import-tiago/It-s-Time-Do/README.md

# It's Time, Do!

__It's Time, Do!__ is a system (hardware + firmware + web application) to control over the internet the on/off or programming to automatically run other devices and electronic equipments.

The inspiration for creating this project comes from the need to schedule my ~~not smart~~ washing machine to auto-start when I'm out and about to save time and just put the clothes to dry when I get home.

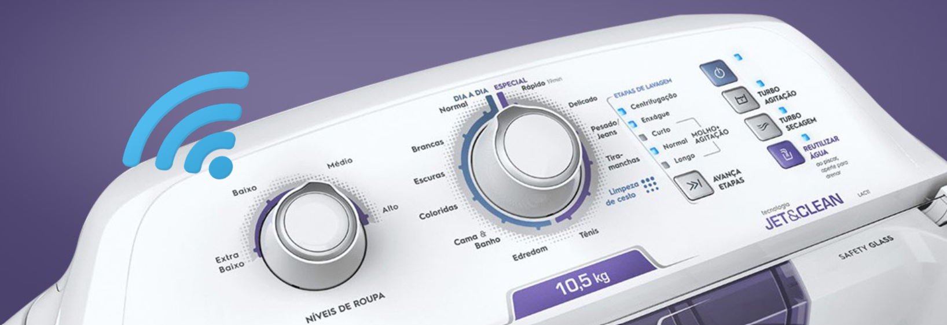
[picture p1: Assets/WashMachinePanel.png]
WashingMachine


## Push Notifications
The hardware device can trigger a web push notification to notify web clients of tasks that have started or ended (either previously scheduled tasks or even tasks that have been started locally).

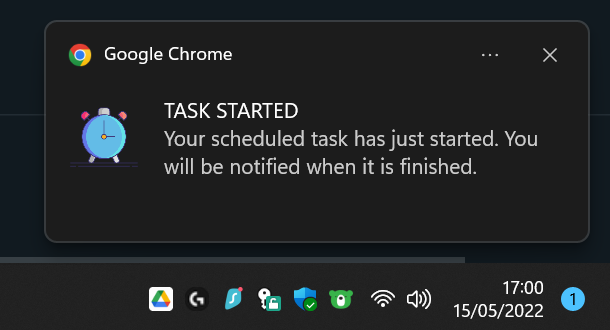
[picture p2: Assets/WebPushNotificationStartTask.png]
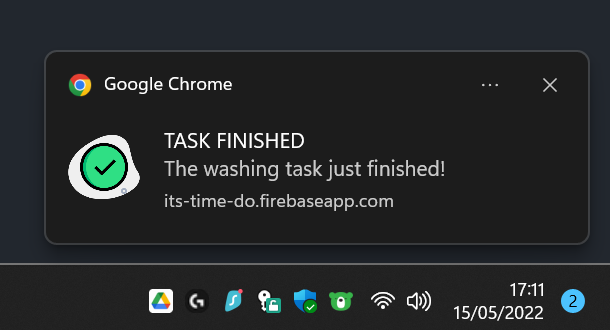
[picture p3: Assets/WebPushNotificationFinishedTask.png]
|  |  |
|--|--|
  
 ## Task History and Instant Data
 Through Firebase's Real Time Database (RTDB), it is possible to monitor instant __It's Time, Do!__ hardware device parameters, such as local date, local time, status of the scheduled task and current firmware version; as well as status of the device being controlled (in my case, the washing machine), whether or not it is working, log of all previous tasks with start and finished date and time of each one.
 <p align="center"><img src="https://github.com/import-tiago/It-s-Time-Do/blob/main/Assets/RTDB_Preview.png" width=70%" height="70%"></p>
  
## Hardware / Circuit Diagram
Controller: [M5StickC PLUS](https://docs.m5stack.com/en/core/m5stickc_plus) - [M5Stack Official Store](https://pt.aliexpress.com/item/1005003297502591.html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)<br/>
Module: [Unit Relay](https://docs.m5stack.com/en/unit/relay) - [M5Stack Official Store](https://pt.aliexpress.com/item/1005003299262655.html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)

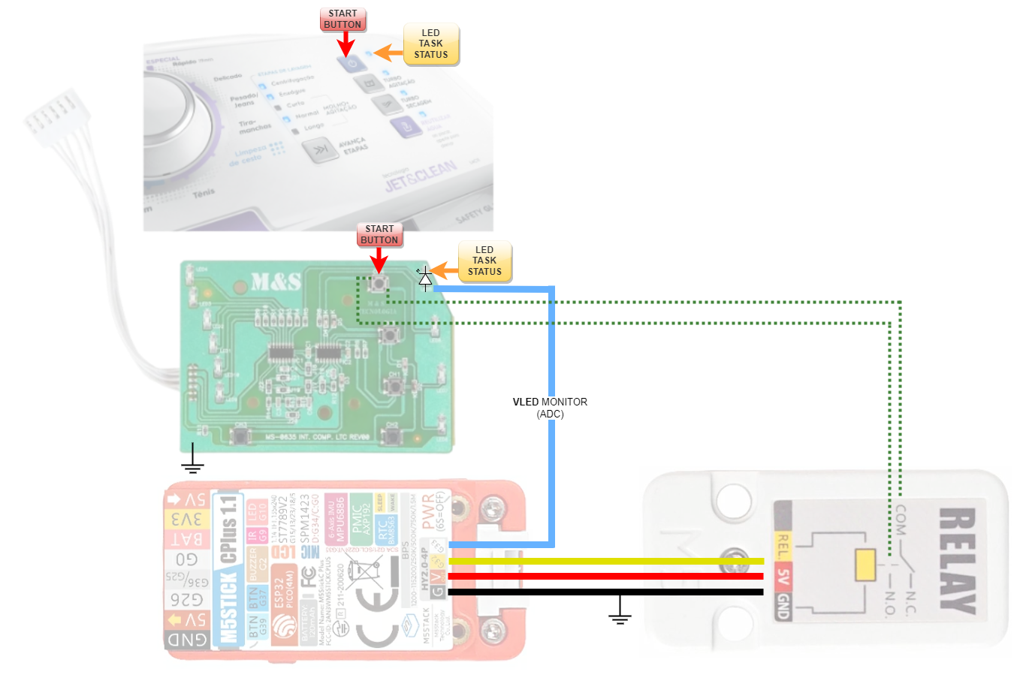
[picture p4: Assets/Circuit.png]
CircuitDiagram


### Contributing
0. Give this project a :star:
1. Create an issue and describe your idea.
2. [Fork it](https://github.com/import-tiago/It-s-Time-Do/fork).
3. Create your feature branch (`git checkout -b my-new-feature`).
4. Commit your changes (`git commit -a -m "Added feature title"`).
5. Publish the branch (`git push origin my-new-feature`).
6. Create a new pull request.
7. Done! :heavy_check_mark:

### License Information
<br /><span xmlns:dct="http://purl.org/dc/terms/" property="dct:title">It's Time, Do!</span> by <a xmlns:cc="http://creativecommons.org/ns#" href="https://twitter.com/import_tiago" property="cc:attributionName" rel="cc:attributionURL">Tiago Silva</a> is licensed under a <a rel="license" href="http://creativecommons.org/licenses/by-nc-sa/4.0/">Creative Commons Attribution-NonCommercial-ShareAlike 4.0 International License</a>.
