import-tiago/It-s-Time-Do/Assets/HardwareUsed.png

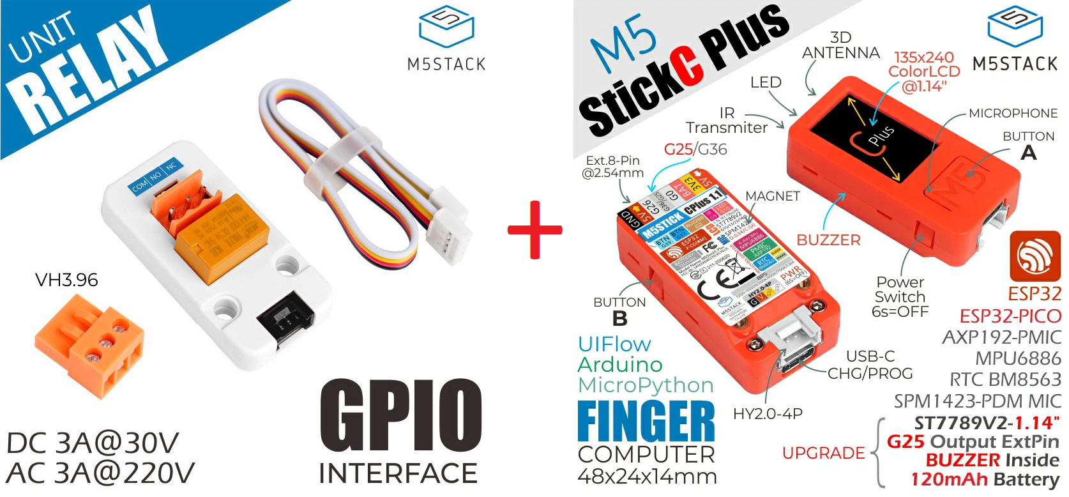
Assets/HardwareUsed.png
