import-tiago/It-s-Time-Do/Assets/RTDB_Preview.png

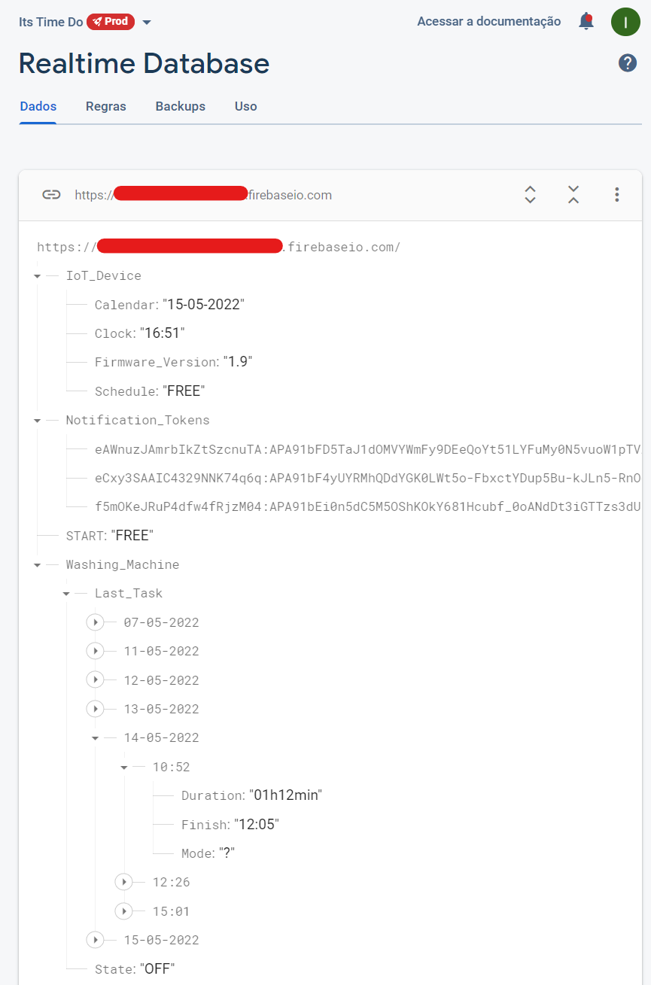
Assets/RTDB_Preview.png
