import-tiago/It-s-Time-Do/Assets/WashMachinePanel_and_PCB.png

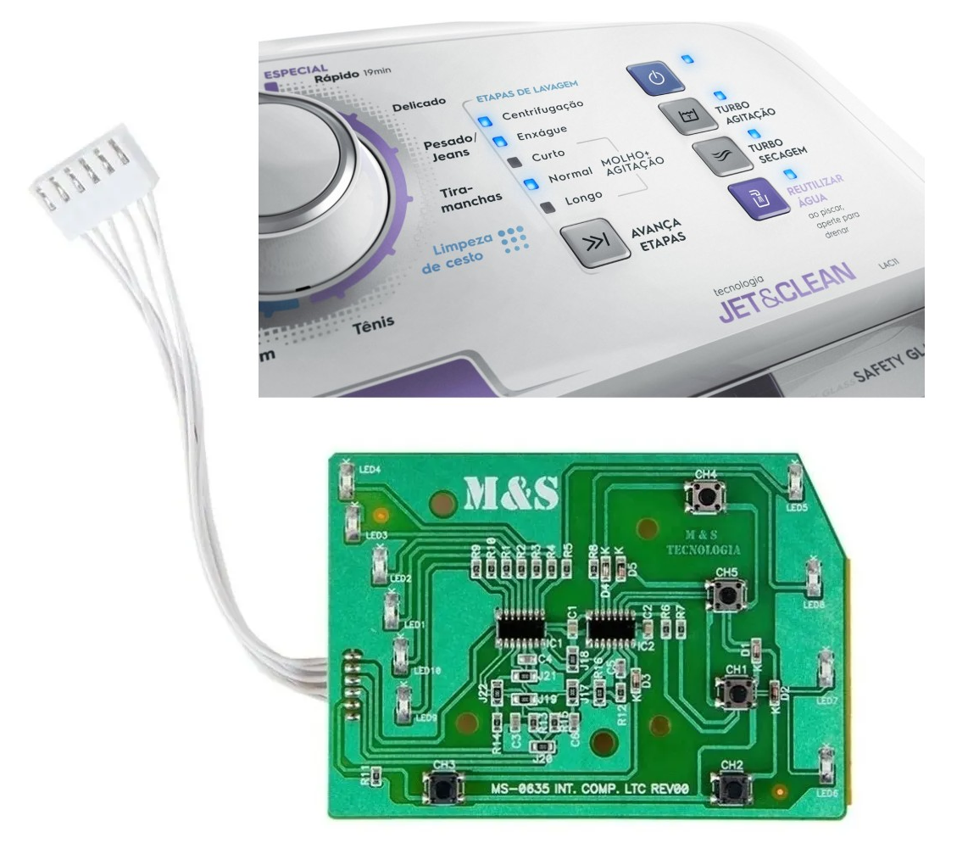
Assets/WashMachinePanel_and_PCB.png
