import-tiago/It-s-Time-Do/Hardware/M5StickC PLUS/Pinout_BOTTOM.webp

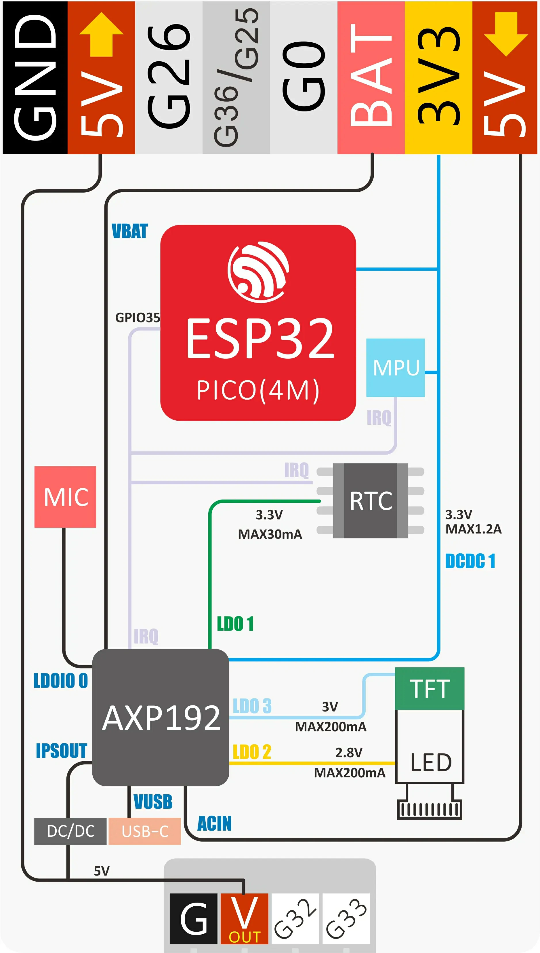
Hardware/M5StickC PLUS/Pinout_BOTTOM.webp
