import-tiago/It-s-Time-Do/Hardware/M5StickC PLUS/Pinout_TOP.webp

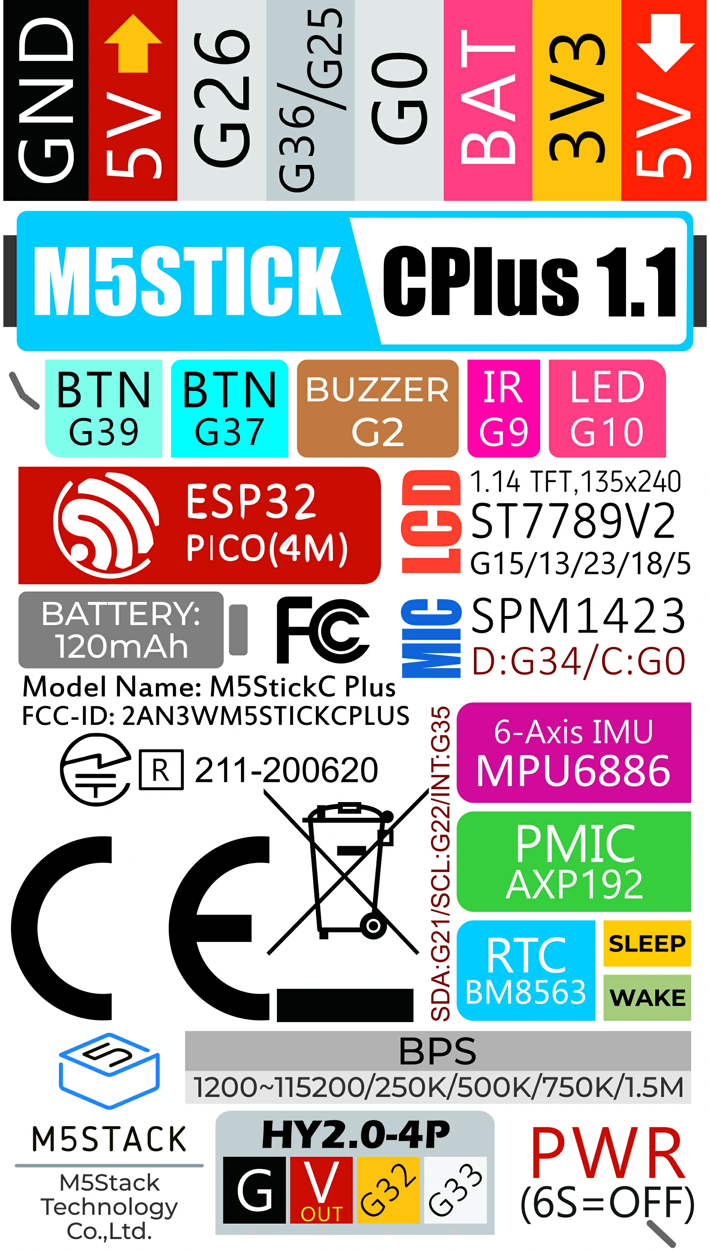
Hardware/M5StickC PLUS/Pinout_TOP.webp
