import-tiago/It-s-Time-Do/Hardware/0. Project/It-s Time, Do.brd

## EAGLE design Hardware/0. Project/It-s Time, Do.brd (2022-06-18, last stored version)

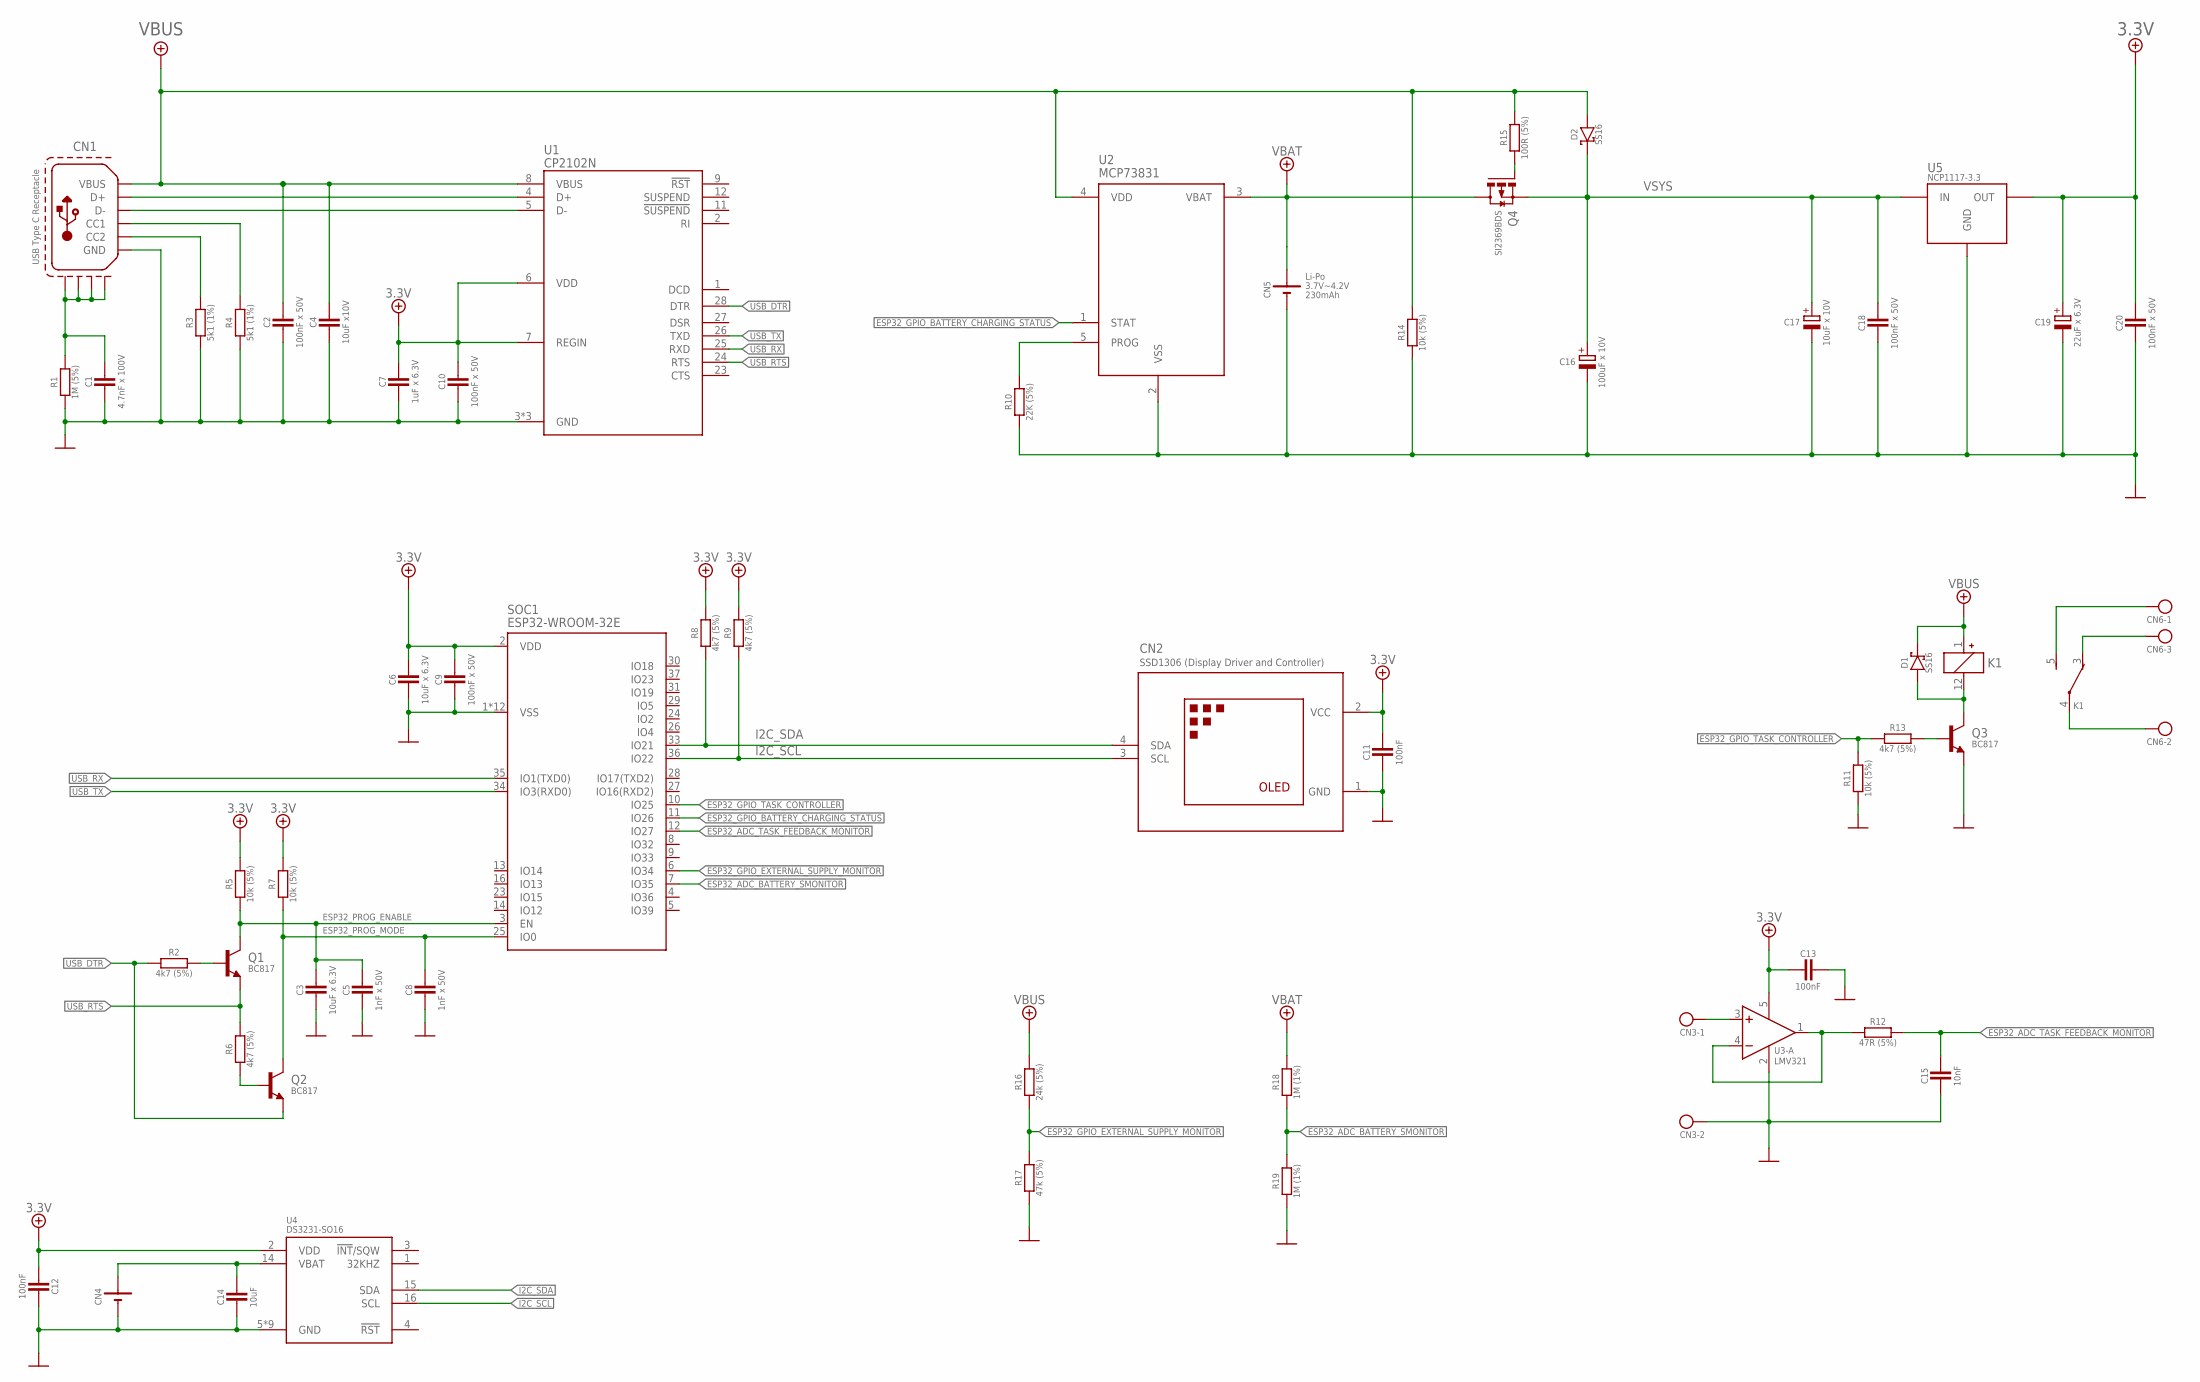
[picture p10: schematic It-s Time, Do.sch, Complete Schematic]

Parts:
C1: 4.7nF x 100V; C0603
C2, C9, C10, C18, C20: 100nF x 50V; C0603
C3, C6: 10uF x 6.3V; C0603
C4: 10uF x10V; C0603
C5, C8: 1nF x 50V; C0603
C7: 1uF x 6.3V; C0603
C11, C12, C13: 100nF; C0603; PARTNO *
C14: 10uF; C0603; PARTNO GRJ155R60J106ME11D
C15: 10nF; C0603
C16: 100uF x 10V; PTH-5MM
C17: 10uF x 10V; C1206_POL
C19: 22uF x 6.3V; C1206_POL
CN1: USB Type C Receptacle; USB-C-16P-2LAYER-PADS
CN2: OLED-MODULE-I2C-SOCKET; PIN_HEADER_1X4_FEMALE
CN3: 2P-MINI-FIT-JR; MINI-FIT-JR-2P
CN4: CR1220; CR1220/1225_HOLDER2; PARTNO *
CN5: BATTERY; JST-PH-2P-H; VOLTAGE 3.7V~4.2V
CN6: 3P-MINI-FIT-JR; MINI-FIT-JR-3P
D1: FM4004; DO-214AC
D2: SCHOTTKY-SS16; DO-214AC
K1: DPDT-SMD; EE2-5NU
Q1, Q2: NPN-BC817; SOT23-3
Q3: BC817; SOT23-3
Q4: P-FET-ENHANCEMENT-SI2369BDS; SOT23-3
R1: 1M (5%); R0603
R2, R6, R8, R9, R13: 4k7 (5%); R0603
R3, R4: 5k1 (1%); R0603
R5, R7, R11, R14: 10k (5%); R0603
R10: 22K (5%); R0603; PARTNO *
R12: 47R (5%); R0603
R15: 100R (5%); R0603
R16: 24k (5%); R0603; PARTNO RC0402FR-0724KL
R17: 47k (5%); R0603; PARTNO RC0402FR-0747KL
R18, R19: 1M (1%); R0603; PARTNO *
SOC1: ESP32-WROOM-32E
U1: CP2102N; QFN-28
U2: MCP73831; SOT-23-5; PARTNO *
U3: LMV321; SOT-23-5
U4: DS3231-SO16; SOIC-16W_(SO16)
U5: 1117-3.3V; SOT-223-3

Connections:
0V: C1.1, C2.1, C3.2, C4.1, C5.2, C6.2, C7.1, C8.2, C9.2, C10.1, C11.2, C12.1, C13.1, C14.2, C15.2, C16.2 (-), C17.2 (-), C18.2, C19.2 (-), C20.2, CN1.GND, CN1.GND2 (GND), CN2.1 (GND), CN3.2, CN4.2 (-), CN5.2 (-), Q3.2 (E), R1.2, R3.2, R4.2, R10.1, R11.2, R14.1, R17.2, R19.1, SOC1.1 (VSS), SOC1.15 (VSS), SOC1.38 (VSS), SOC1.E1 (VSS), SOC1.E2 (VSS), SOC1.E3 (VSS), SOC1.E4 (VSS), SOC1.E5 (VSS), SOC1.E6 (VSS), SOC1.E7 (VSS), SOC1.E8 (VSS), SOC1.E9 (VSS), U1.3 (GND), U1.EXP (GND), U1.M (GND), U2.2 (VSS), U3.2 (V-), U4.5 (GND), U4.6 (GND), U4.7 (GND), U4.8 (GND), U4.9 (GND), U4.10 (GND), U4.11 (GND), U4.12 (GND), U4.13 (GND), U5.1 (GND)
3.3V: C6.1, C7.2, C9.1, C10.2, C11.1, C12.2, C13.2, C19.1 (+), C20.1, CN2.2 (VCC), R5.1, R7.1, R8.2, R9.2, SOC1.2 (VDD), U1.6 (VDD), U1.7 (REGIN), U3.5 (V+), U4.2 (VDD), U5.2 (OUT), U5.4 (OUT)
ESP32_ADC_BATTERY_SMONITOR: R18.1, R19.2, SOC1.7 (IO35)
ESP32_ADC_TASK_FEEDBACK_MONITOR: C15.1, R12.2, SOC1.12 (IO27)
ESP32_GPIO_BATTERY_CHARGING_STATUS: SOC1.11 (IO26), U2.1 (STAT)
ESP32_GPIO_EXTERNAL_SUPPLY_MONITOR: R16.2, R17.1, SOC1.6 (IO34)
ESP32_GPIO_TASK_CONTROLLER: R11.1, R13.2, SOC1.10 (IO25)
ESP32_PROG_ENABLE: C3.1, C5.1, Q1.3 (C), R5.2, SOC1.3 (EN)
ESP32_PROG_MODE: C8.1, Q2.3 (C), R7.2, SOC1.25 (IO0)
I2C_SCL: CN2.3 (SCL), R9.1, SOC1.36 (IO22), U4.16 (SCL)
I2C_SDA: CN2.4 (SDA), R8.1, SOC1.33 (IO21), U4.15 (SDA)
unnamed: CN1.B5 (CC2), R3.1
unnamed: CN1.A5 (CC1), R4.1
unnamed: CN1.A7 (D-), CN1.B7 (D-), U1.5 (D-)
unnamed: CN3.1, U3.3 (+IN)
unnamed: CN6.1, K1.5 (NO)
unnamed: CN1.A6 (D+), CN1.B6 (D+), U1.4 (D+)
unnamed: Q1.1 (B), R2.1
unnamed: Q2.1 (B), R6.1
unnamed: Q4.1 (G), R15.2
unnamed: R12.1, U3.1 (OUT), U3.4 (-IN)
unnamed: CN6.2, K1.4 (COM)
unnamed: CN6.3, K1.3 (NC)
unnamed: R10.2, U2.5 (PROG)
unnamed: Q3.1 (B), R13.1
unnamed: D1.2 (A), K1.12 (-), Q3.3 (C)
unnamed: C1.2, CN1.SHLD1 (S1), CN1.SHLD2 (S2), CN1.SHLD3 (S3), CN1.SHLD4 (S4), R1.1
P$1: CN5.1 (+), Q4.3 (D), R18.2, U2.3 (VBAT)
RTC_VBAT: C14.1, CN4.1 (+), U4.14 (VBAT)
USB_DTR: Q2.2 (E), R2.2, U1.28 (DTR)
USB_RTS: Q1.2 (E), R6.2, U1.24 (RTS)
USB_RX: SOC1.35 (IO1(TXD0)), U1.25 (RXD)
USB_TX: SOC1.34 (IO3(RXD0)), U1.26 (TXD)
VBUS: C2.2, C4.2, CN1.VBUS1 (VBUS), CN1.VBUS2 (VBUS), D1.1 (K), D2.2 (A), K1.1 (+), R14.2, R15.1, R16.1, U1.8 (VBUS), U2.4 (VDD)
VSYS: C16.1 (+), C17.1 (+), C18.1, D2.1 (K), Q4.2 (S), U5.3 (IN)

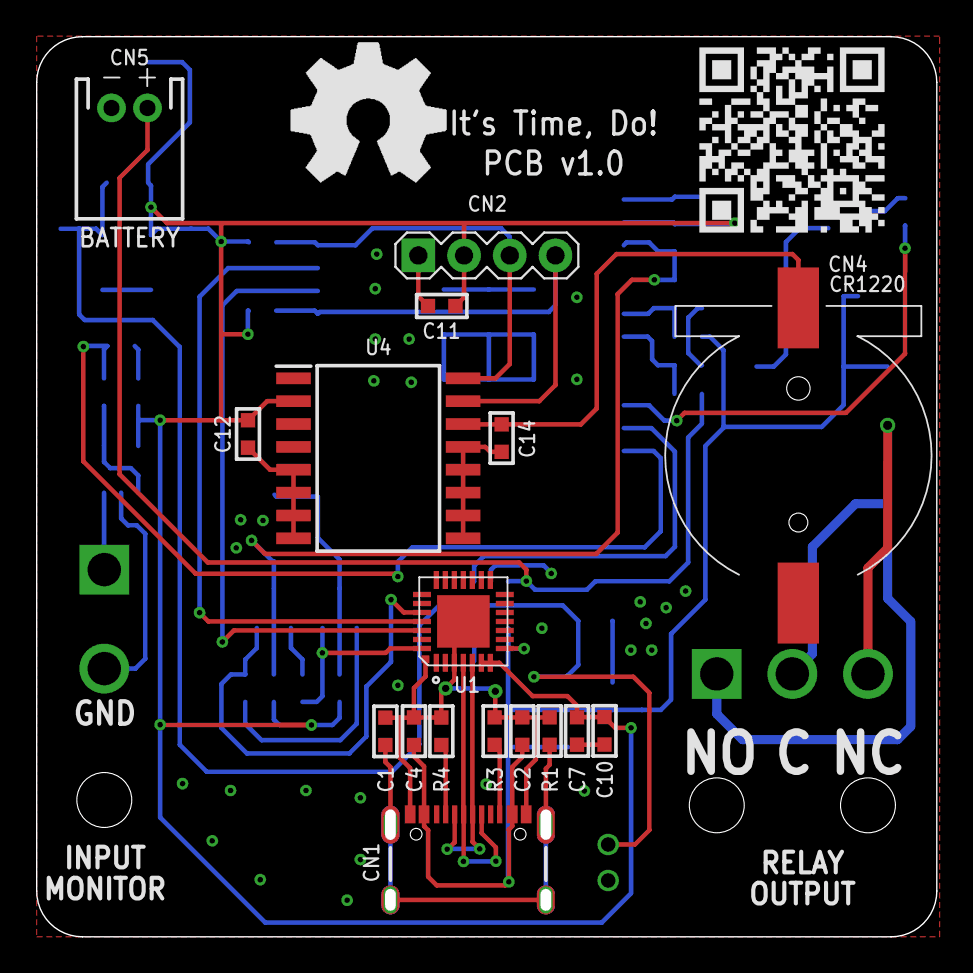
[picture p11: board It-s Time, Do.brd from above]

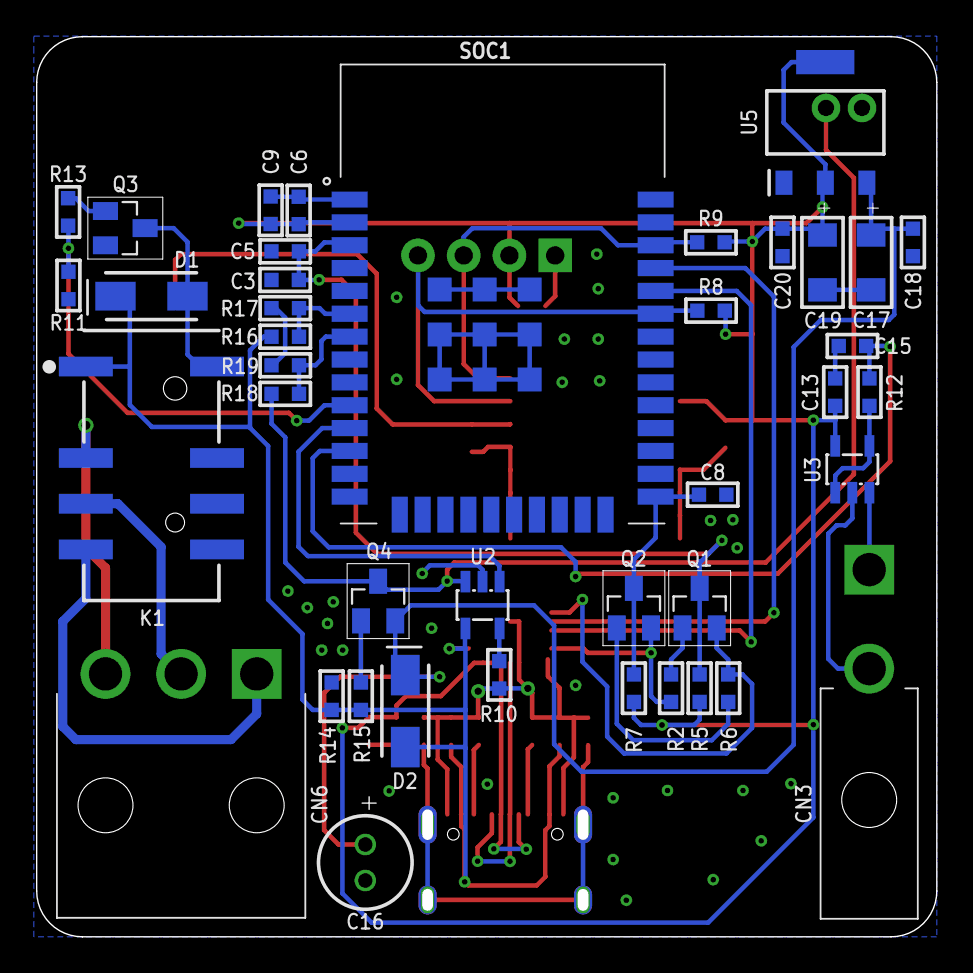
[picture p12: board It-s Time, Do.brd from below]

Board: 2 copper layers, 50.0 x 50.0 mm, 58 parts (41 on the bottom side), 35 nets.
