import-tiago/It-s-Time-Do/Firmware/src/main.cpp

#define FIRMWARE_VERSION "2.1"
/*
v1.0    - Initial release.
v1.1    - Bug fix in task duration calcs.
v1.2    - Update library 'Firebase-ESP32' from  v3.1.5 to v3.2.0.
v1.3    - Reading and writing data from/to server changed to JSON method.
		- More information besides 'task duration' added to the finished task log.
		- New data struct standard defined to store data in the real remote_time_adj database.
		- Print current task duration while waits the task finish.
		- Allows task duration monitor/log works from local or remote START trigger.
v1.4    - Enable Checks_OTA_Firmware_Update() on firmware start-up.
		- Enable Wi-Fi and Firebase connections status print on firmware start-up.
		- Checks if Firebase is ready before send JSON data to RTDB.
v1.4.1  - Bug fix: show working state at /START topic after remote trigger.
		- Bug fix: show free state at /START and /IoT_Device topics after task finished.
		- Send push notification when remote triggers occurs.
		- Calendar postion changed to fit firmware version text.
v1.4.2  - Bug fix: local trigger does not need trigger relay. Fixed.
v1.5    - Current firmware version sendind to RTDB.
v1.6    - New firmware structure based on finite state machine, no more just ISR.
v1.7  	- 'Firebase-ESP32' library updated from v3.2.0 to v3.3.0.
		- Minor improvements in variables/functions names (more intuitive code reading).
		- Bug fix in Last_Task fild (data being erased after some remote_time_adj).
v1.8 	- Static variables changed to extern where appropriate.
v1.8.1 	- Now, Firebase_Get runs 'FirebaseReady' to ensure the connection in while loops.
		- 'Firebase-ESP32' library updated from v3.3.0 to v3.2.2 (author's downgrade)
v1.9 	- 'Firebase-ESP32' library updated from v3.2.2 to v3.3.2.
		- Ensures that when task is RUNNING the /IoT_Device/Schedule shows status as RUNNING too.
v1.10 	- 'Firebase-ESP32' library updated from v3.3.2 to v3.3.6.
		- 'RTClib' library updated from v2.0.2 to v2.0.3.
v1.11 	- 'Firebase-ESP32' library updated from v3.3.6 to v4.0.0.
		- 'download_buffer_size' increased.
v1.12 	- Fixed espressif32 platform at v3.5.0 because mbedtls (associated function) seems to have broken a bunch of libraries using it at new versions.
v1.13 	- 'Firebase-ESP32' library updated from v4.0.0 to v4.1.0.
v2.0    - Porting whole firmware to a new hardware platform: M5StickC Plus.
v2.1    - RTC IC from M5StickC Plus auto-update from NTP server after successfully Wi-Fi connection.
		- RSSI and Wi-Fi quality stability improved.
*/

/* Native libraries */
#include <M5StickCPlus.h>
#include "Free_Fonts.h"

/* Own libraries */
#include "my_network.h"
#include "Main_Application.h"
#include "MY_RTC.h"
#include "my_display.h"
#include "my_hal.h"

#include "soc/rtc_wdt.h"
#include <freertos/FreeRTOS.h>
#include <freertos/task.h>

#define LOCAL_ADJ 1
uint8_t predominant_adj = 0;
String local_time_adj;

#define DISPLAY_TURN_OFF_TIMEOUT (1 * 60 * 1000) // 1 MINUTE
uint32_t turnOff_display_timeout = 0;

bool display_power_state_controller(uint8_t state) {

	static bool current_state = true;
	static bool last_state = true;

	if (last_state != current_state)
		last_state = current_state;

	switch (state) {

		case HIGH: {
			if (last_state != state) {
				M5.Axp.SetLDO2(true);
				Serial.println("DISPLAY TURN ON");
			}
			turnOff_display_timeout = millis();
			current_state = true;
			break;
		}

		case LOW: {
			if (last_state != state) {
				M5.Axp.SetLDO2(false);
				Serial.println("DISPLAY TURN OFF");
			}
			current_state = false;
			last_state = false;
			break;
		}
	}

	return last_state;
}

void download_cloud_data() {

	if (Firebase.RTDB.getString(&fbdo, F("/START"))) {

		String remote_time_adj = fbdo.to<const char*>();

		if (isValid_Time(remote_time_adj)) {

			if (predominant_adj == LOCAL_ADJ) {
				if (local_time_adj == remote_time_adj) {
					Next_Task = remote_time_adj;
					predominant_adj = 0;
				}
			}
			else {
				static String last_remote_time_adj = Washing_Machine.FREE;
				Next_Task = remote_time_adj;
				if (Next_Task != last_remote_time_adj) {
					Serial.println("NEW TIME FROM CLOUD");
					last_remote_time_adj = remote_time_adj;
					display_power_state_controller(HIGH);
				}
			}

			/* 			JSON.clear();
						if (Get_Firebase_JSON_at("/Notification_Tokens", &JSON)) {
							Extract_List_of_Web_Push_Notifications_Device_Tokens();
							JSON_Deserialized.clear();
						} */
		}
		else {
			if (!Task.running && predominant_adj != LOCAL_ADJ)
				Next_Task = Washing_Machine.FREE;
		}
	}
	else
		Serial.println(fbdo.errorReason().c_str());
}

void upload_cloud_data() {

	FirebaseJson json;

	json.add(F("/IoT_Device/Calendar"), Current_Date(FULL));
	json.add(F("/IoT_Device/Clock"), Current_Clock(WITHOUT_SECONDS));
	json.add(F("/IoT_Device/Schedule"), Next_Task);
	json.add(F("/IoT_Device/Firmware_Version"), FIRMWARE_VERSION);

	json.add(F("/Washing_Machine/State"), Get_Washing_Machine_Power_State(TARGET_DEVICE_POWER_LED) ? "ON" : "OFF");

	if (Next_Task == Washing_Machine.FAIL)
		json.add(F("/START"), Washing_Machine.FAIL);

	if (predominant_adj == LOCAL_ADJ)
		json.add(F("/START"), Next_Task);

	//if (Next_Task == Washing_Machine.FREE)
	//	json.add(F("/START"), Get_Washing_Machine_Power_State(TARGET_DEVICE_POWER_LED) ? Washing_Machine.WORKING : Washing_Machine.FREE);

	if (Task.new_report) {
		Task.new_report = false;
		Task.running = false;

		json.add(F("/START"), Washing_Machine.FREE);

		char data[100] = { 0 };

		siprintf(data, "/Washing_Machine/Last_Task/%s/%s/Finish", Task.initial_date.c_str(), Task.initial_time.c_str());
		json.add(data, Task.finished_time);

		siprintf(data, "/Washing_Machine/Last_Task/%s/%s/Mode", Task.initial_date.c_str(), Task.initial_time.c_str());
		json.add(data, Washing_Machine.washing_mode);

		siprintf(data, "/Washing_Machine/Last_Task/%s/%s/Duration", Task.initial_date.c_str(), Task.initial_time.c_str());
		json.add(data, Task.duration);
	}

	Serial.printf("update node... %s\n", Firebase.RTDB.updateNode(&fbdo, F("/"), &json) ? "ok" : fbdo.errorReason().c_str());
}

void firebase_tasks(void* arg) {

	while (1) {

		static uint32_t t0 = 0;

		if (Firebase.ready() && (millis() - t0 >= 15000 || !t0)) {
			t0 = millis();
			download_cloud_data();
			upload_cloud_data();
		}
	}
}

void adjustment_monitor() {

	M5.update();

	static uint32_t t0 = 0;
	static uint32_t t1 = 0;
	static bool count_secs = true;
	static bool beep = false;
	const uint8_t hold_time_trigger = 3;

	if (M5.BtnA.isPressed() || M5.BtnB.isPressed()) {

		if (count_secs) {
			t0 = millis();
			count_secs = false;
		}

		if ((millis() - t0) >= 1000) {
			t1++;
			count_secs = true;
		}

		if (t1 >= hold_time_trigger && !beep) {
			M5.Beep.beep();
			delay(50);
			M5.Beep.mute();
			delay(50);
			beep = true;
		}
	}

	if (M5.BtnA.wasReleased() || M5.BtnB.wasReleased()) {

		/*
		 If the last diplsay state was turn off (LOW), this click doesn't means a task time adjustment request.
		 This just means a request to turn-on the diplsay, so, just return from here.
		*/
		if (!display_power_state_controller(HIGH))
			return;

		if (t1 >= hold_time_trigger) {
			Next_Task = Washing_Machine.FREE;
			local_time_adj = Washing_Machine.FREE;
			predominant_adj = LOCAL_ADJ;
			t0 = 0;
			t1 = 0;
			count_secs = true;
			beep = false;
			return;
		}

		int hour = Next_Task.substring(0, Next_Task.indexOf(":")).toInt();
		int min = Next_Task.substring(Next_Task.indexOf(":") + 1).toInt();

		if (Next_Task == Washing_Machine.FREE || Next_Task == Washing_Machine.FAIL) {

			M5.Rtc.GetTime(&RTC_TimeStruct);

			if (RTC_TimeStruct.Minutes > 50) {

				hour = RTC_TimeStruct.Hours;
				hour++;
				if (hour >= 24)
					hour = 0;

				min = 0;
			}
			else {
				hour = RTC_TimeStruct.Hours;
				min = RTC_TimeStruct.Minutes + (10 - (RTC_TimeStruct.Minutes % 10));
			}
		}

	#define ADJ_MINS 1
	#define ADJ_HOURS 2
	#define ADJ_FINISHED 3

		uint8_t adj_step = ADJ_MINS;
		bool adj_finished = false;

		uint32_t t0 = millis();

		char current_clock[6];
		char target_clock[6];

	#define TIMEOUT_VALUE 10
		uint8_t timeout = TIMEOUT_VALUE;
		bool blinky = false;

		do {

			if (millis() - t0 > 500) {
				static uint8_t secs_count = 0;
				t0 = millis();
				if (++secs_count == 2) {
					timeout--;
					secs_count = 0;
				}
				blinky = !blinky;
			}

			tftSprite.fillSprite(0x18E3); //Eerie black (RGB-565)

			// CURRENT CLOCK
			tftSprite.fillRect(0, 0, tftSprite.width(), 35, TFT_ORANGE);
			tftSprite.setTextColor(BLACK);
			tftSprite.setFreeFont(&Orbitron_Light_24);

			M5.Rtc.GetTime(&RTC_TimeStruct);
			sprintf(current_clock, "%02d:%02d", RTC_TimeStruct.Hours, RTC_TimeStruct.Minutes);

			tftSprite.setTextDatum(TC_DATUM);
			tftSprite.drawString(current_clock, tftSprite.width() / 2, 4);
			// ----------------------------------------------------------------



			// "NEXT TASK" TITLE
			tftSprite.setFreeFont(&Orbitron_Light_24);
			tftSprite.setTextColor(0xAEDE); // Uranian Blue (RGB-565)
			tftSprite.setTextDatum(CC_DATUM);
			tftSprite.drawString("NEXT TASK:", tftSprite.width() / 2, tftSprite.height() / 2);
			// ----------------------------------------------------------------



			// SCHEDULE ADJUSTMENT
			if (blinky && adj_step == ADJ_MINS)
				sprintf(target_clock, "%02d:%02d", hour, min);

			else if (!blinky && adj_step == ADJ_MINS) {
				sprintf(target_clock, "__:%02d", min);
			}

			if (blinky && adj_step == ADJ_HOURS)
				sprintf(target_clock, "%02d:%02d", hour, min);
			else if (!blinky && adj_step == ADJ_HOURS)
				sprintf(target_clock, "%02d:__", hour);

			tftSprite.setTextColor(0xEFBF); // Alice Blue (RGB-565)
			tftSprite.setFreeFont(&Orbitron_Light_32);
			tftSprite.setTextDatum(BC_DATUM);
			tftSprite.drawString(target_clock, tftSprite.width() / 2, tftSprite.height() - 7);
			// ----------------------------------------------------------------


			// TIMEOUT VALUE
			tftSprite.setFreeFont(&Orbitron_Light_24);
			tftSprite.setTextDatum(CC_DATUM);
			tftSprite.setTextColor(0x32D2); // Bdazzled blue (RGB-565)
			tftSprite.fillRect(tftSprite.width() - 40, tftSprite.height() - 40, 40, 40, 0x18E3); //Eerie black (RGB-565)
			tftSprite.drawString(String(timeout), tftSprite.width() - 20, tftSprite.height() - 20);
			tftSprite.setTextDatum(BC_DATUM);
			tftSprite.setTextColor(0xEFBF); // Alice Blue (RGB-565)
			// ----------------------------------------------------------------

			tftSprite.pushSprite(0, 0);

			M5.update();

		#define UP M5.BtnB.wasReleased()
		#define ENTER M5.BtnA.wasReleased()

			if (UP) {

				timeout = TIMEOUT_VALUE;

				if (adj_step == ADJ_MINS) {
					hour++;
					if (hour >= 24)
						hour = 0;
				}

				if (adj_step == ADJ_HOURS) {
					min += 10;
					if (min >= 60)
						min = 0;
				}
			}

			if (ENTER) {

				timeout = TIMEOUT_VALUE;

				if (adj_step == ADJ_MINS)
					adj_step = ADJ_HOURS;

				else if (adj_step == ADJ_HOURS)
					adj_step = ADJ_FINISHED;

				if (adj_step == ADJ_FINISHED)
					adj_finished = true;

				M5.Beep.beep();
				delay(50);
				M5.Beep.mute();
				delay(50);
			}

			if (!timeout)
				adj_finished = true;

		} while (!adj_finished);

		if (timeout) {

			char buf[6];
			sprintf(buf, "%02d:%02d", hour, min);

			Next_Task = buf;

			//------------
			predominant_adj = LOCAL_ADJ;
			local_time_adj = Next_Task;
			//------------

			for (uint8_t i = 0; i < 3; i++) {
				M5.Beep.beep();
				delay(50);
				M5.Beep.mute();
				delay(50);
			}
		}
	}
}

void system_states_manager() {

	switch (Current_System_State) {

		case STARTING: {

			Next_Task = Washing_Machine.FREE;

			Current_System_State = LOCAL_SCHEDULE_ADJUSTMENT;

			break;
		}

		case LOCAL_SCHEDULE_ADJUSTMENT: {
			adjustment_monitor();
			Current_System_State = DISPLAY_UPDATE;
			break;
		}

		case DISPLAY_UPDATE: {

			TFT_Clear();

			if (Task.running) {
				TFT_Build_Working_Screen(Task_Duration_Calc(Task.initial_timestamp, Get_Current_Timestamp()), FIRMWARE_VERSION);
				display_power_state_controller(HIGH);
			}
			else
				TFT_Build_Home_Screen(Next_Task, FIRMWARE_VERSION);

			tftSprite.pushSprite(0, 0);

			Current_System_State = LOCAL_TRIGGER_MONITOR;
			break;
		}

		case LOCAL_TRIGGER_MONITOR: {

			if (!Task.running && Get_Washing_Machine_Power_State(TARGET_DEVICE_POWER_LED)) {
				Next_Task = Washing_Machine.WORKING;

				Task.running = true;

				Get_Task_Initialization_Parameters();

				//Send_Web_Push_Notification(Push_Notification.init.TASK_INIT);
			}

			if (isValid_Time(Next_Task))
				Current_System_State = SCHEDULED_TRIGGER_MONITOR;
			else
				Current_System_State = TASK_STATUS_MONITOR;

			break;
		}

		case SCHEDULED_TRIGGER_MONITOR: {

			int hour = Next_Task.substring(0, Next_Task.indexOf(":")).toInt();
			int min = Next_Task.substring(Next_Task.indexOf(":") + 1).toInt();
			const int sec = 0;

			int day = Current_Date(JUST_DAY).toInt();
			int month = Current_Date(JUST_MONTH).toInt();
			int year = Current_Date(JUST_YEAR).toInt();

			uint32_t current_timestamp = Get_Current_Timestamp();
			uint32_t schedule_timestamp = Calc_Timestamp(hour, min, sec, day, month, year);

			if (((current_timestamp >= schedule_timestamp) && (current_timestamp <= (schedule_timestamp + 120))) && !Get_Washing_Machine_Power_State(TARGET_DEVICE_POWER_LED))
				Start_Task();
			else
				Current_System_State = TASK_STATUS_MONITOR;

			break;
		}

		case TASK_STATUS_MONITOR: {

			if (Task.running && !Get_Washing_Machine_Power_State(TARGET_DEVICE_POWER_LED)) {

				Task.running = false;

				Task.new_report = true;

				Next_Task = Washing_Machine.FREE;

				Get_Task_Finalization_Parameters();

				Task.duration = Task_Duration_Calc(Task.initial_timestamp, Get_Current_Timestamp());

				//Send_Web_Push_Notification(Push_Notification.end.TASK_FINISH);
			}

			Current_System_State = LOCAL_SCHEDULE_ADJUSTMENT;
			break;
		}
	}
}

void setup() {

	init_gpios();
	init_tft_display();

	if (init_wifi())
		init_firebase();

	xTaskCreatePinnedToCore(firebase_tasks, "FirebaseTasks", 8 * 1024, NULL, 1, NULL, 1);
}

void loop() {
	if ((millis() - turnOff_display_timeout) >= DISPLAY_TURN_OFF_TIMEOUT)
		display_power_state_controller(LOW);

	system_states_manager();
}
