import-tiago/It-s-Time-Do/(commit log)

2022-04-17 bug fix in 'last task duration' calc
    [main.cpp]
2022-04-22 Web App + Push Notifications from Hardware Device trigger added
2022-04-24 Web push notifications trigger from init and finished task on hardware device
2022-04-27 firmware v1.4.2 release (bug fix)
    [main.cpp]
2022-05-15 Schematic WIP
    [It's Time, Do.sch]
2022-05-15 Schematic v1.0 release
    [It-s Time, Do.brd, It-s Time, Do.sch]
2022-05-15 Board design WIP
    [It-s Time, Do.brd, It-s Time, Do.sch]
2022-05-16 Schematic v1.1 release
    - Minor improvements on parts designators position;
    - Just one resistor as pull up in not used pins at OLED display.
    [It-s Time, Do.brd, It-s Time, Do.sch]
2022-05-26 Firmware v1.10 release
    - 'Firebase-ESP32' library updated from v3.3.2 to v3.3.6.
    - 'RTClib' library updated from v2.0.2 to v2.0.3.
2022-06-18 PCB v1.0 release
    [It-s Time, Do.brd, It-s Time, Do.sch]
2022-07-02 Firmware v1.12 release
    - Fixed espressif32 platform at v3.5.0 because mbedtls (associated function) seems to have broken a bunch of libraries using it in the new versions.
    [main.cpp]
2023-03-26 M5StickC PLUS set as official new hardware (WIP)
    [It-s Time, Do.brd, It-s Time, Do.sch]
2023-04-09 added gnd ref to the circuit
2023-04-13 circuit design improved
2023-11-26 FW v2.1 release
    - RTC IC from M5StickC Plus auto-update from NTP server after successfully Wi-Fi connection.
    - RSSI and Wi-Fi quality stability improved.
    [main.cpp]
