import-tiago/It-s-Time-Do/(notices)

Notices in the files:
parts and their libraries:
My-RLC: Copyright (C) 2007, Bob Starr
